PowerFeather/powerups-usb-protection/(commit log)

2024-10-27 First schematic and layout
    [powerups-usb-protection.kicad_pcb, powerups-usb-protection.kicad_sch]
2024-10-31 Some adjustments to copper pour
    [powerups-usb-protection.kicad_pcb]
2024-10-31 Use full receptacle symbol
    [powerups-usb-protection.kicad_pcb, powerups-usb-protection.kicad_sch]
2024-10-31 Add silkscreen for which side is which
    [powerups-usb-protection.kicad_pcb]
2024-11-01 Update powerfeather kicad lib
    Also add ground in between data lines
    [powerups-usb-protection.kicad_pcb]
2024-11-01 Set part numbers
    [powerups-usb-protection.kicad_pcb, powerups-usb-protection.kicad_sch]
2024-11-01 Fix dmn3016 solder mask
    [powerups-usb-protection.kicad_pcb]
2024-11-01 Prepare for fabrication
    [powerups-usb-protection.kicad_pcb, powerups-usb-protection.kicad_sch]
2024-11-01 Generate output files
    [powerups-usb-protection-B_Cu.gbl, powerups-usb-protection-B_Mask.gbs, powerups-usb-protection-B_Paste.gbp, powerups-usb-protection-B_Silkscreen.gbo, powerups-usb-protection-Edge_Cuts.gm1, powerups-usb-protection-F_Cu.gtl, powerups-usb-protection-F_Mask.gts, powerups-usb-protection-F_Paste.gtp]
2024-11-10 Fix ncv68261 footprint and symbol
    [powerups-usb-protection.kicad_pcb, powerups-usb-protection.kicad_sch]
2024-11-10 Remove stray silkscreen
    [powerups-usb-protection.kicad_pcb]
2024-11-10 Update version
    [powerups-usb-protection.kicad_pcb, powerups-usb-protection.kicad_sch]
2024-11-10 Update fab outputs
    [powerups-usb-protection-B_Cu.gbl, powerups-usb-protection-B_Mask.gbs, powerups-usb-protection-B_Paste.gbp, powerups-usb-protection-B_Silkscreen.gbo, powerups-usb-protection-Edge_Cuts.gm1, powerups-usb-protection-F_Cu.gtl, powerups-usb-protection-F_Mask.gts, powerups-usb-protection-F_Paste.gtp]
